samuelalvcardoso/Front-Crash-Management-System/CODE PRIMARY/Bumper_two.igs

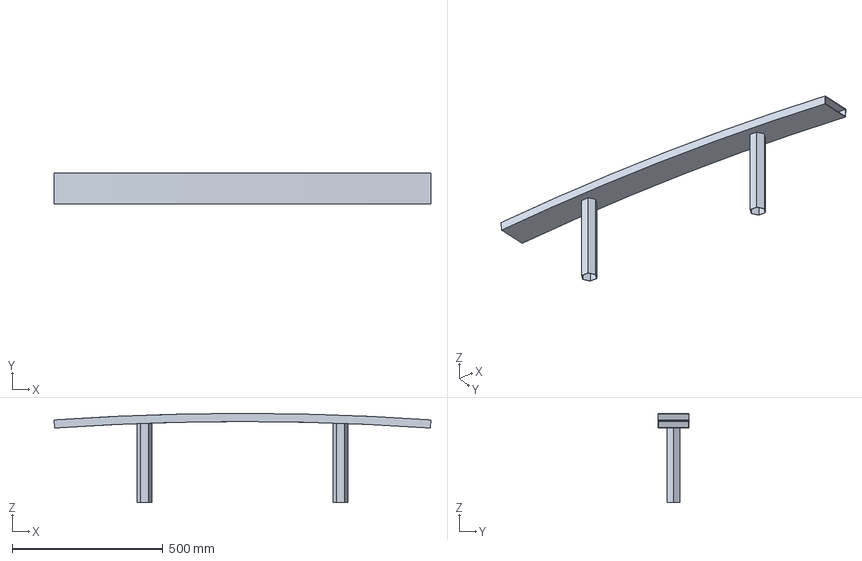
[picture p11: CAD file, 2021-03-13]
CODE PRIMARY/Bumper_two.igs
1250.1 x 102.0 x 295.9 mm
