samuelalvcardoso/Front-Crash-Management-System/CODE SECONDARY/Bumper_two_double.igs

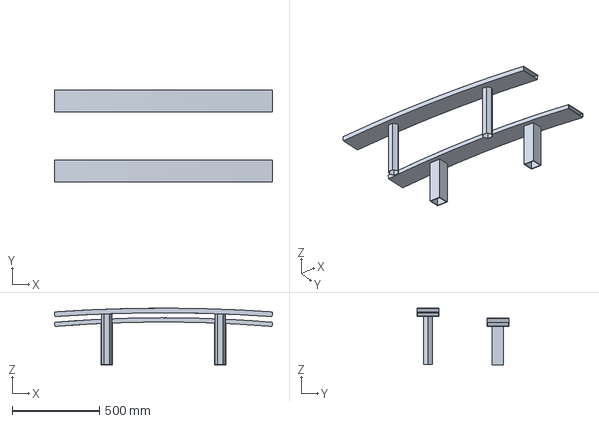
[picture p12: CAD file, 2021-03-13]
CODE SECONDARY/Bumper_two_double.igs
1250.2 x 525.8 x 325.6 mm
