samuelalvcardoso/Front-Crash-Management-System/(list of files, cad)

Other CAD files:
CODE PRIMARY/Bumper_two.CATPart
CODE SECONDARY/Bumper_two_double.CATPart
